Rishabh416/Ocean_Monitoring_Submarine/(list of files, cad)

Other CAD files:
Submarine Project v10.f3d
Submarine Project v4.f3d
Submarine Project v9.f3d
