Rishabh416/Ocean_Monitoring_Submarine/(commit log)

2024-08-24 added switch for manual recording
2025-01-18 3D Model v4 upload
    [Submarine Project v4.f3d]
2025-01-19 3D model fully assembled
    [Submarine Project v9.f3d]
2025-04-04 updated thruster code
2025-04-18 added support for 3 thrusters
